tsdcosta/SES---Solar-Panel-Drive-Mechanism/Chapters/9.conclusion.tex

\section{Final remarks and recommendations}

also include what and why is not perfect
explain how it could be better in a larger application/system

 -- if only communication between the boards is interrupted, both send signals to the motors, etc. system fails

hand in video of explaining the project
