tsdcosta/SES---Solar-Panel-Drive-Mechanism/figures/circuit.jpg

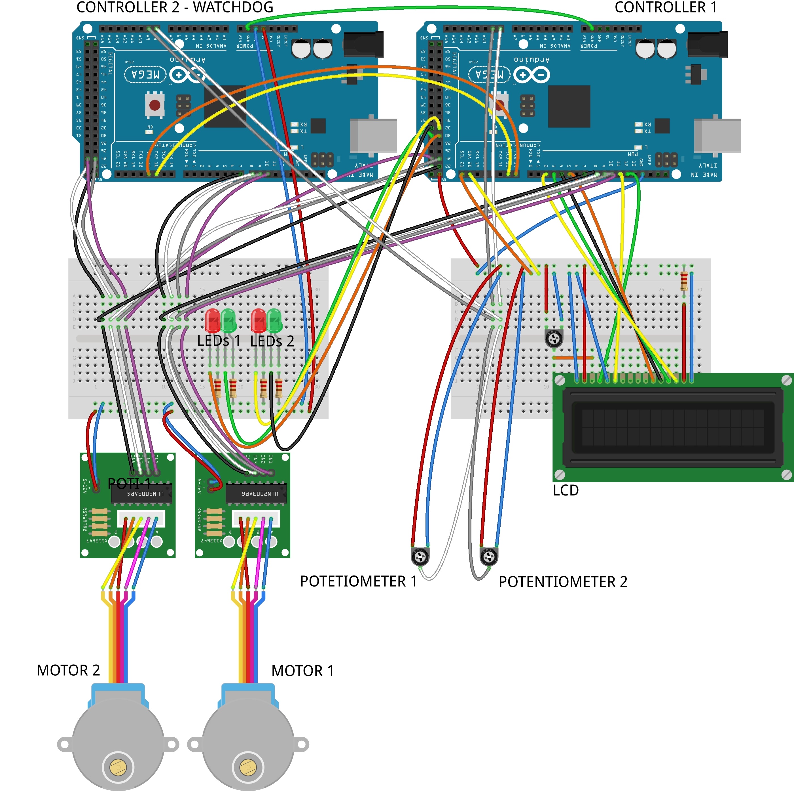
figures/circuit.jpg
