tsdcosta/SES---Solar-Panel-Drive-Mechanism/figures/circuit_pic.jpg

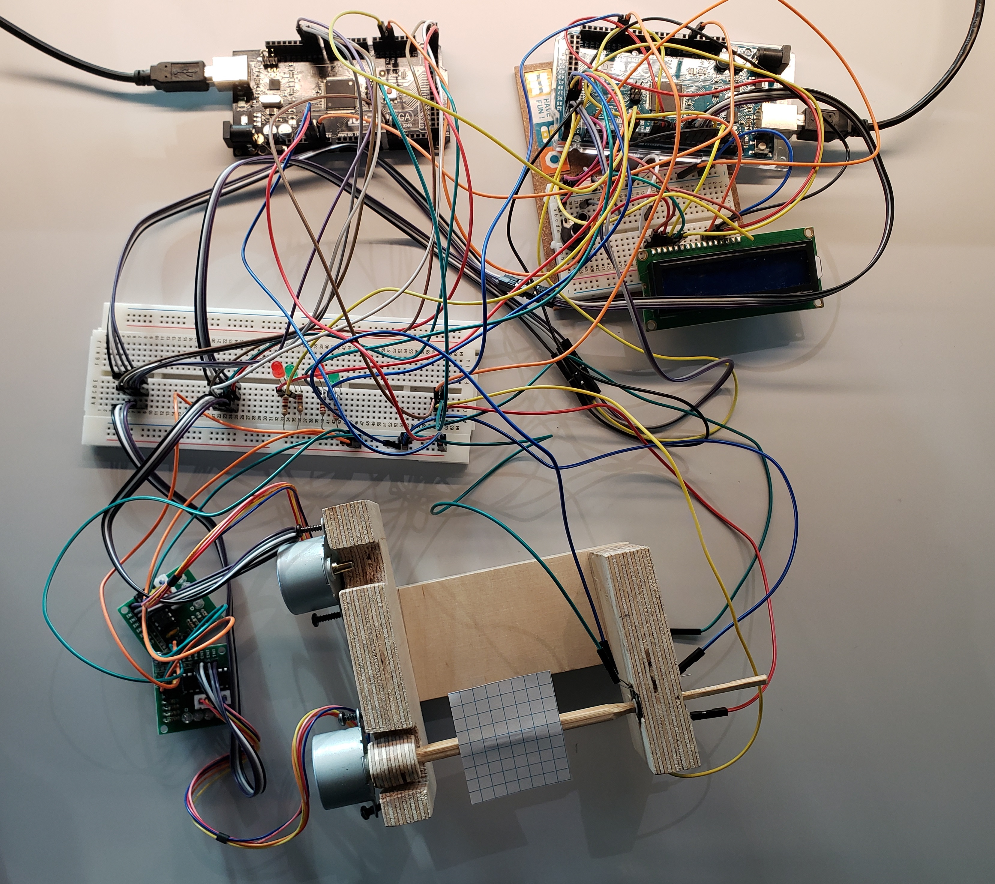
figures/circuit_pic.jpg
