tsdcosta/SES---Solar-Panel-Drive-Mechanism/figures/fdir.jpg

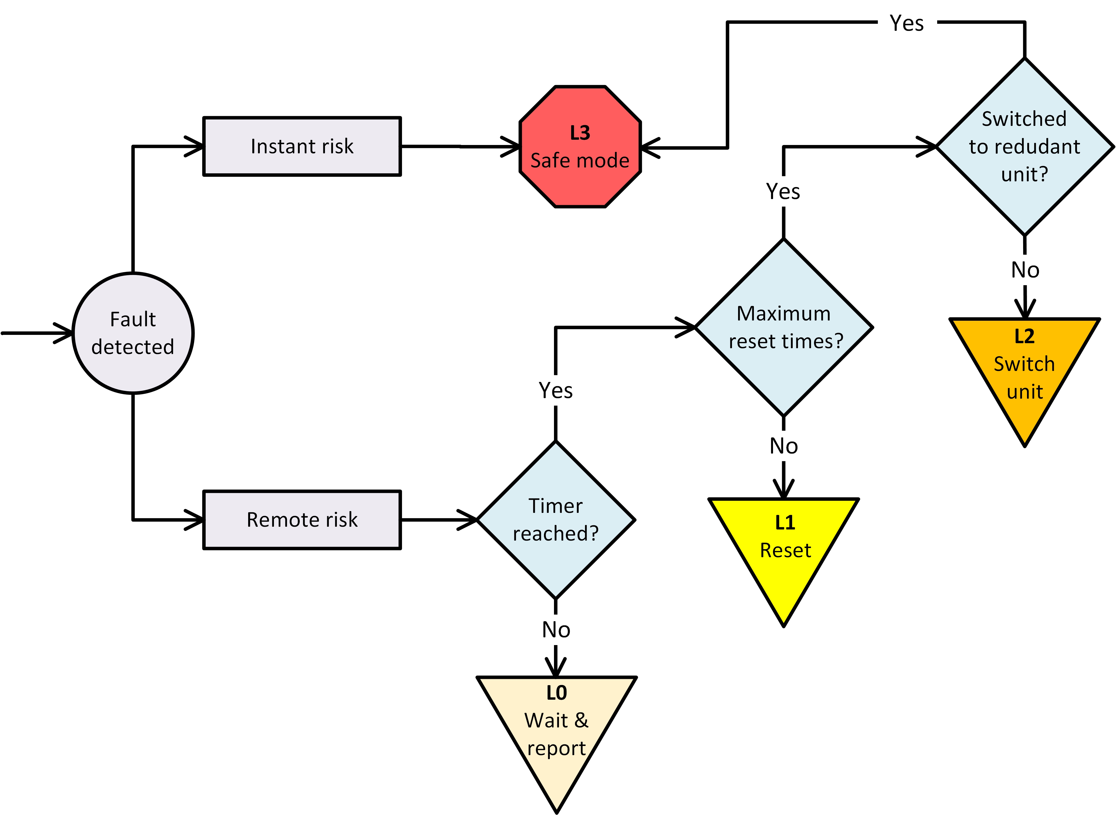
figures/fdir.jpg
