tsdcosta/SES---Solar-Panel-Drive-Mechanism/figures/mech01.jpg

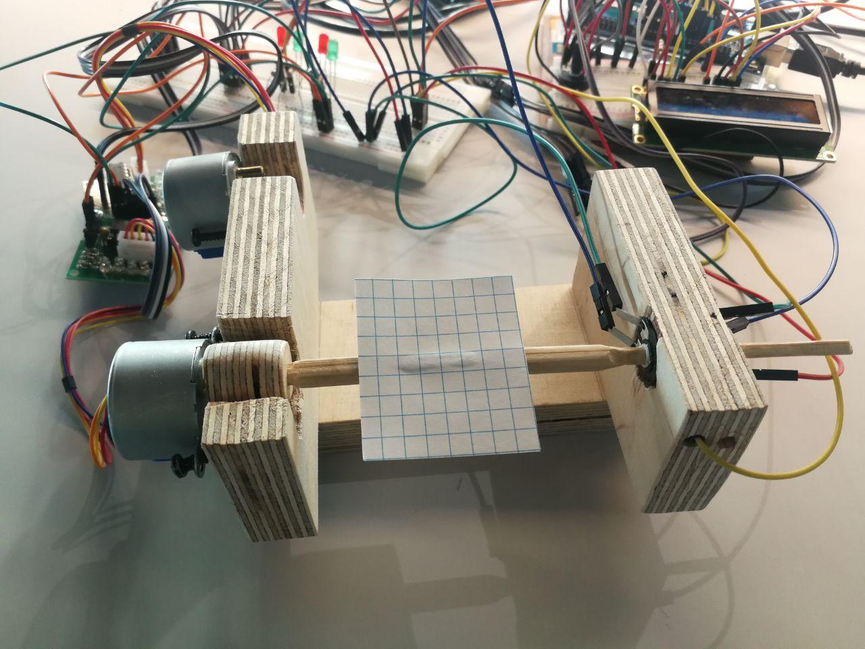
figures/mech01.jpg
