tsdcosta/SES---Solar-Panel-Drive-Mechanism/figures/mech02.jpg

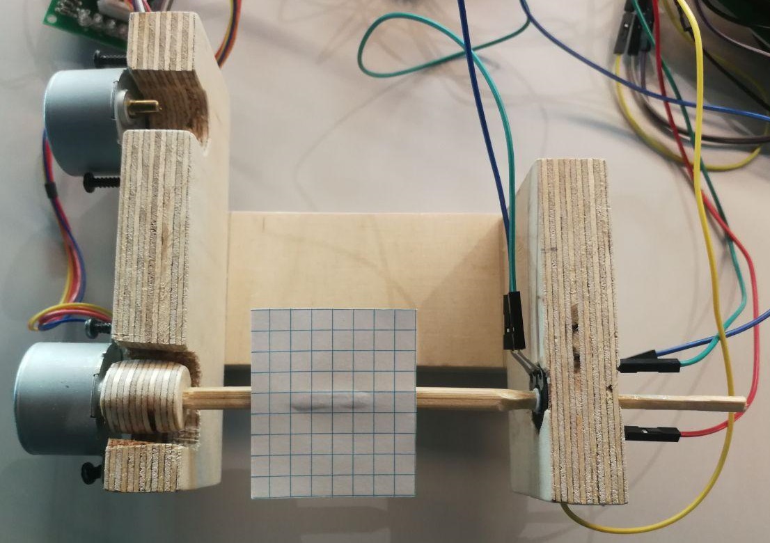
figures/mech02.jpg
