tsdcosta/SES---Solar-Panel-Drive-Mechanism/figures/pot1.jpg

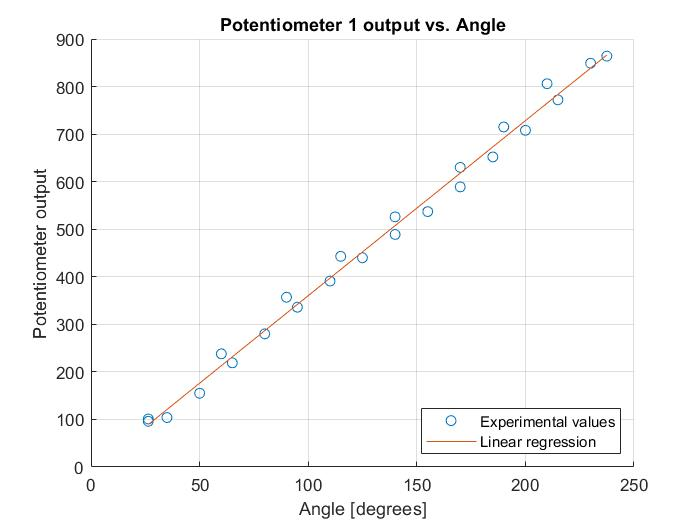
figures/pot1.jpg
