tsdcosta/SES---Solar-Panel-Drive-Mechanism/figures/pot2.jpg

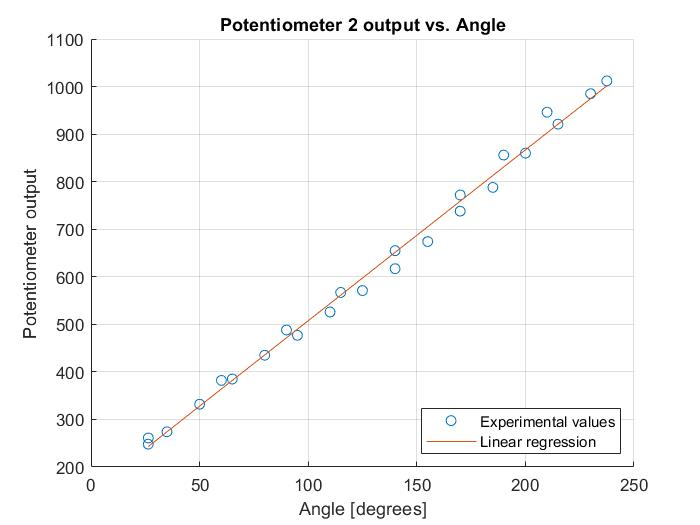
figures/pot2.jpg
