tsdcosta/SES---Solar-Panel-Drive-Mechanism/figures/pot.JPG

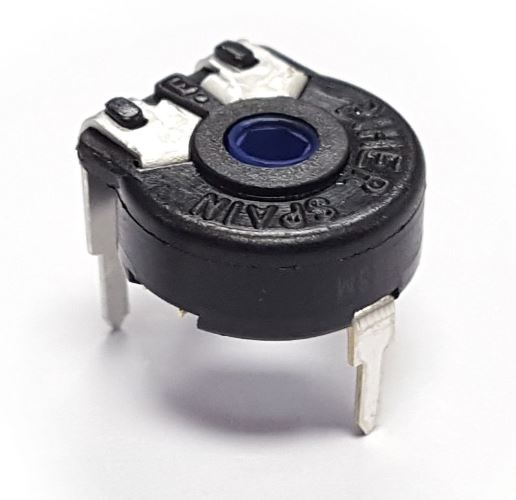
figures/pot.JPG
