tsdcosta/SES---Solar-Panel-Drive-Mechanism/figures/steppermotor_board.jpg

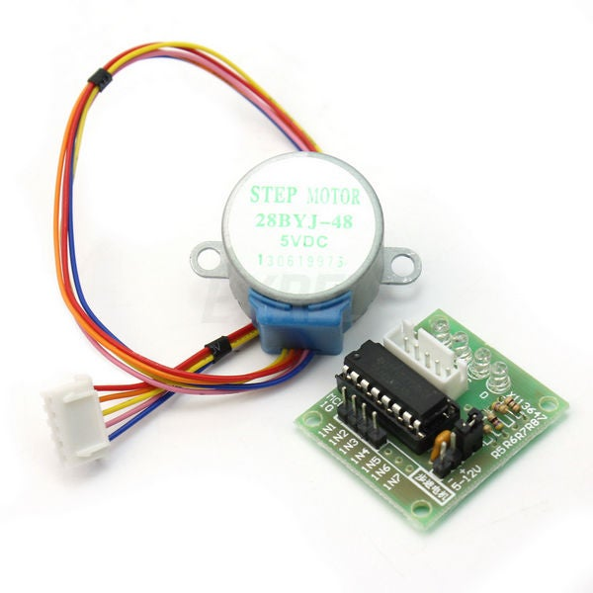
figures/steppermotor_board.jpg
